fstroobandt/IR_line_follower/YouTube_links.txt

Youtube Links:

Auto met 2 wielen:
https://www.youtube.com/watch?v=cxPOhy2jSIM

Auto met 4 wielen:
https://www.youtube.com/watch?v=XgcI8E7g9I4
