fstroobandt/IR_line_follower/Documentatie IoT Project week 7.docx

# Documentatie IoT Project

Frederik Stroobandt

1Gr – IoT Thomas More Hogeschool

Sint-Katelijne-Waver, Campus De Nayer

30 mei ’21 (Week 7)

# 1 Code

## Screenshots van code

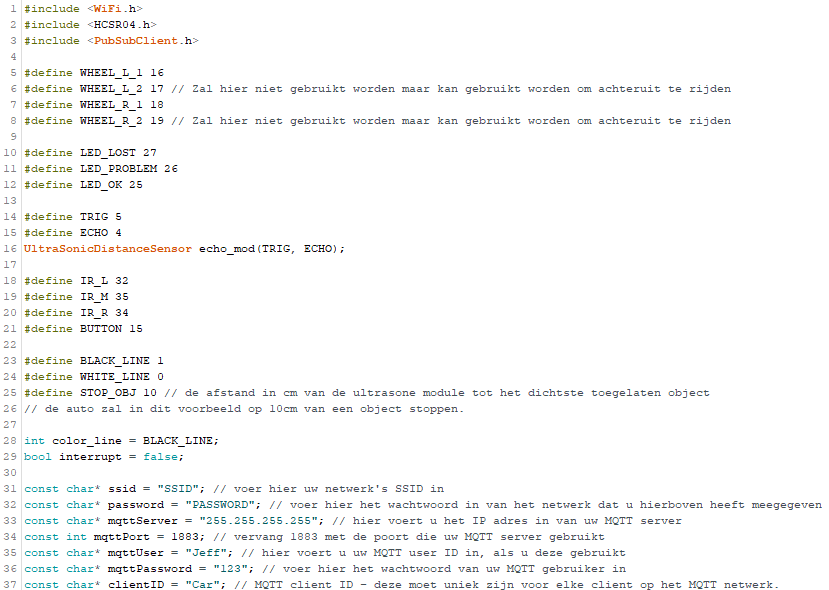
[picture p1: figure]
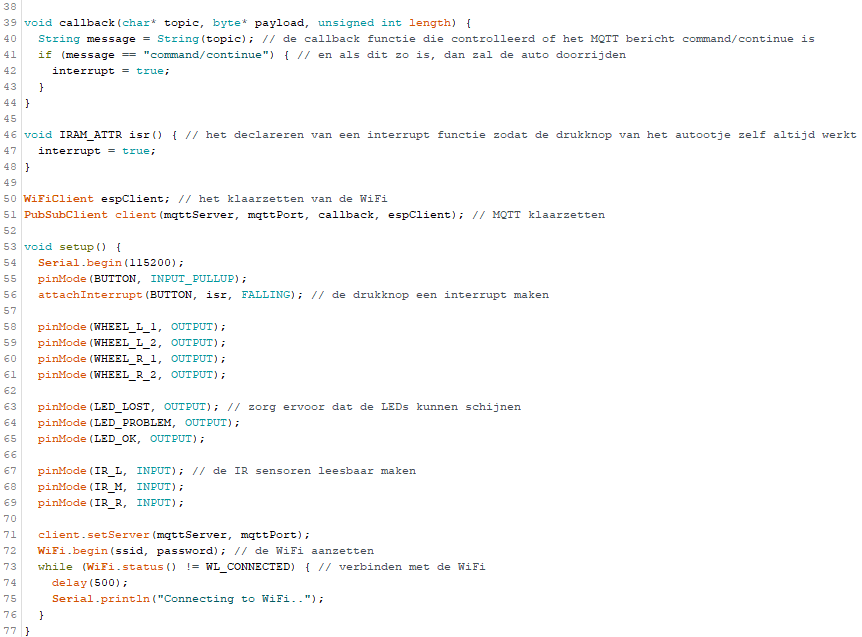
[picture p2: figure]
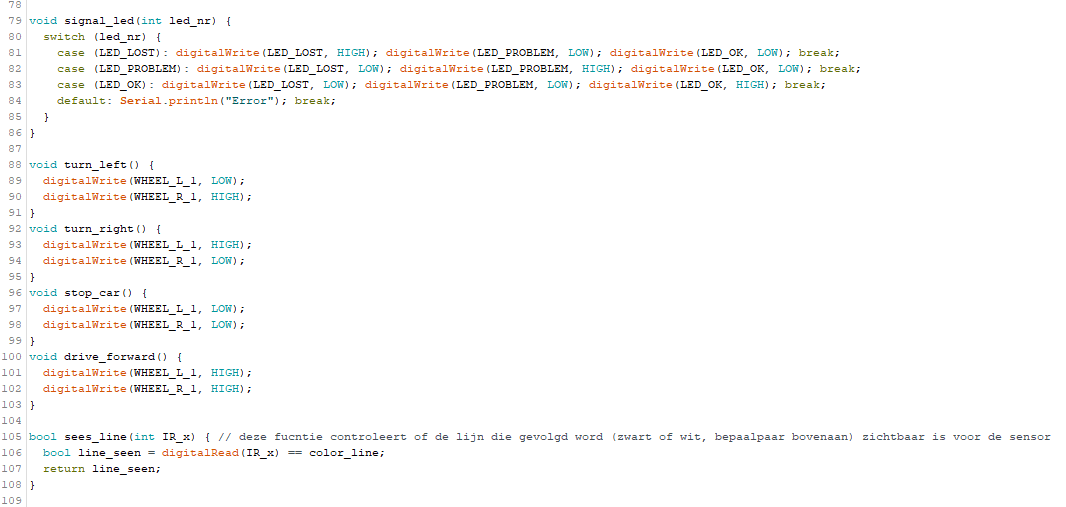
[picture p3: figure]
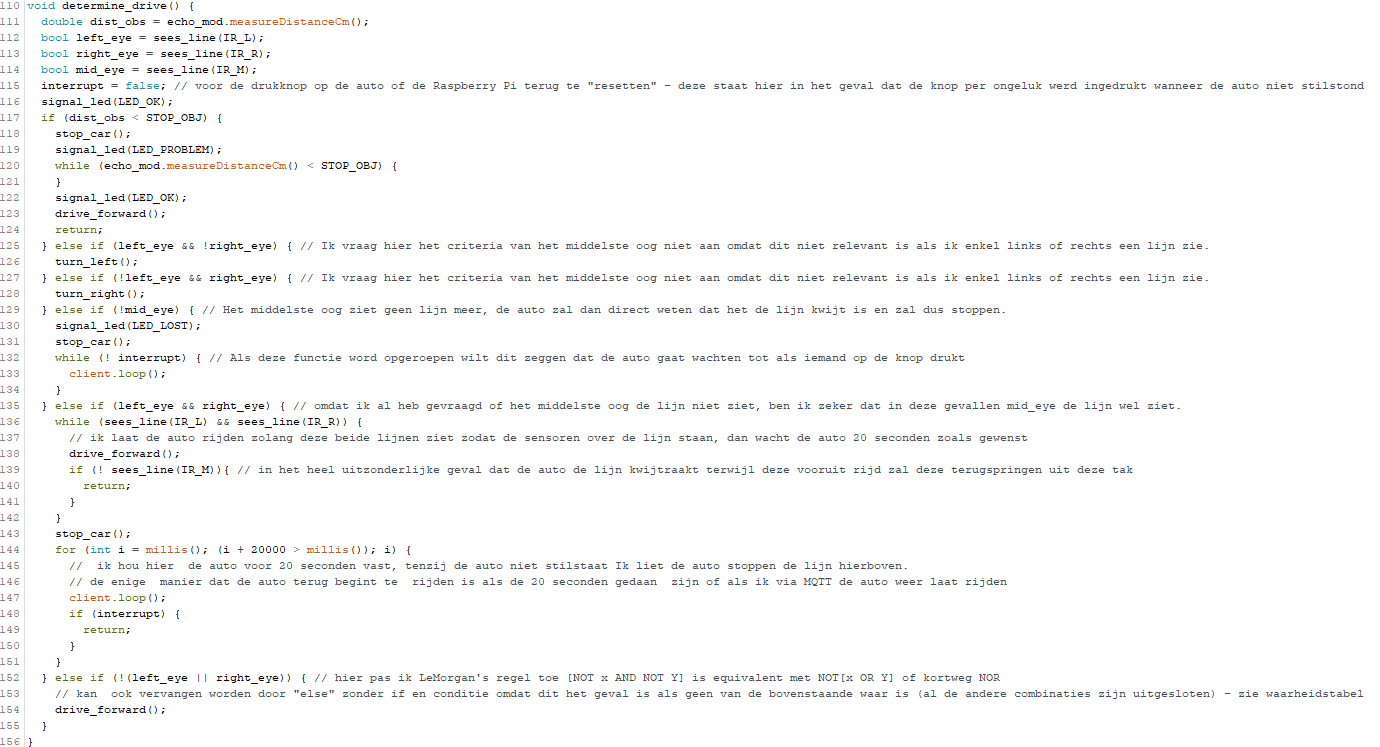
[picture p4: figure]
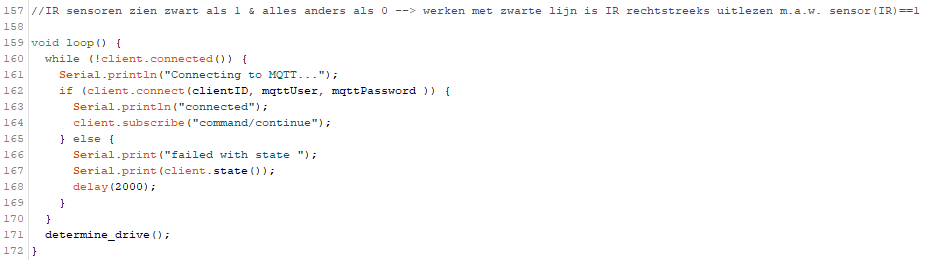
[picture p5: figure]

## Uitleg

In de eerste drie lijnen code roep ik libraries aan die ik nodig zal hebben voor deze robot te maken, de voornaamste twee zijn de WiFi.h en de PubSubClient.h libraries die ervoor zullen zorgen dat ik dankzij MQTT-berichten zal kunnen ontvangen. De HCSR04.h library is de library die mij de Ultrasone sensor laat uitmeten in centimeters zodat ik zelf geen berekening meer moet doen a.d.h.v. de snelheid van geluid.

In de lijnen 4 t.e.m. 37 declareer ik variabelen, objecten en constanten die ik later in mijn code gebruik zodat ik slechts op een plaats in mijn code een aanpassing moet maken als ik bedrading aanpas.

In dit stuk kan u aanpassen welke kleur lijn u volgt (lijn 28 int color_line=…), en u moet tussen lijnen 31 en 37 de code aanpassen zodat deze werkt met uw netwerk en uw MQTT-netwerk.

Tussen lijnen 38 en 52 declareer ik nog twee functies die Setup() nodig heeft. De callback functie voor MQTT berichten te verwerken en isr(), een functie die als interrupt werkt voor de ESP32, hierna worden de espClient en client objecten aangemaakt voor te verbinden met WiFi en MQTT.

Tussen 53 en 77 gebeurt de setup, hier declareer ik welke pinnen er als output zullen dienen en welke als input, ik vertel mijn WiFi en client objecten eveneens welke SSID en MQTT-server ze respectievelijk mee moeten verbinden. En dan wacht ik tot er een verbinding is gemaakt tussen de ESP32 en de WiFi. Dit wil zeggen: zonder WiFi zal de auto niet werken.

De functie signal_led krijgt meegegeven welke LED aan moet springen, en zal de twee andere uitschakelijken, dit doe ik aan de hand van een switch case, dit heb ik gedaan in een functie in het geval ik meerdere keren van LED moet veranderen en heb zo van 3x (# keer van LED veranderen) naar 7 + (#keer van LED veranderen) lijnen code gegaan.

In de turn_left, turn_right, stop_car en drive_forward functies gebruik ik heel simpele code zodat het leesbaarder is.

sees_line(int IR_x) is weeral een functie die niet per se nodig is, maar wel handig is voor de leesbaarheid van de hele code.

determine_drive() is het brein van de code van de auto, hierin wordt bepaald hoe de auto moet rijden, in de eerste vier lijnen maakt de functie 4 lokale variabelen aan en houd deze bij zodat elke vergelijking in de body met gelijke parameters verloopt. Eerst kijkt de functie of er geen object te kortbij staat, in dit geval slechts 10 centimeter, ik vertel de auto om dan onmiddellijk te stoppen en de oranje/gele LED aan te zetten zodat er visueel gesignaleerd wordt dat de auto is gestopt wegens een obstakel. Zodra het obstakel meer dan 10 cm verwijderd is zal de Auto de groene LED aanzetten en gewoon vooruitrijden (dit kan ik nog verwijderen).

In de tweede IF-tak wordt gecontroleerd of het linkeroog de streep ziet, maar het rechteroog niet, zo ja, dan slaat de auto links af. In de derde IF-tak gebeurt het omgekeerde, of het rechteroog de streep ziet maar het linkeroog niet, zo ja, dan slaat de auto rechts af.

Op lijn 129 wordt er voor de eerste (en enige) keer naar de meting van het middelste oog gekeken. Als deze geen lijn ziet dan slaat de auto stil, de rode lamp zal aanduiden dat de auto is gestopt en niet verder zal rijden tot er op een knop wordt gedrukt, en zal pas in een andere tak springen als het probleem is opgelost.

Hierna kijkt de wagen of beide sensoren de lijn zien, zo ja, dan blijft het rijden tot het over de streep staat en dan stopt het. Zodra deze of 20 seconden heeft gewacht aan de lijn, of een signaal krijgt van het commandocentrum zodat de wielen weer draaien, zal de loop voortgaan en wacht de auto niet meer.

De laatste tak is enkel vooruitrijden, als de twee buitenste ogen niets uitlezen, (en het middelste oog wel – dit is impliciet gecontroleerd door lijn 129), dan zal de auto vooruitrijden.

In de loop zal er telkens een connectie gemaakt worden met de MQTT-server, zodat de auto de MQTT-berichten van het commandocentrum kan ontvangen en deze kan verwerken a.d.h.v. de geschreven callback functie, deze zal de nuttige berichten van de nutteloze berichten scheiden. En dan op het einde van de loop roep ik determine_drive() aan zodat de robotauto de lijn kan volgen. Dit wil zeggen: De Auto zal niet werken zonder MQTT.

### Code zonder WiFi en MQTT

Als u de code wilt zonder dat WiFi en MQTT gebruikt worden moet u een beetje code weghalen.
Te verwijderen lijnen (Ik raad aan om onderaan te beginnen, dan blijven de lijnnummers juist):
1, 3, 30 t.e.m. 44, 50 t.e.m. 52, 70 t.e.m. 76, 133, 147 en dan 160 t.e.m. 170.

Er zal ook een download link zijn op GitHub voor de code zonder WiFi en MQTT.

## Waarheidstabel voor de 3 IR-ogen

↓ Scenario | left_eye | mid_eye | right_eye
Lost | 0 | 0 | 0
Right | 0 | 0 | 1
Drive | 0 | 1 | 0
Right | 0 | 1 | 1
Left | 1 | 0 | 0
Lost | 1 | 0 | 1
Left | 1 | 1 | 0
Stop | 1 | 1 | 1

In deze waarheidstabel kunnen we zien dat er slechts 5 scenario’s zijn die we nodig hebben. Dus om van 8 scenario’s (alle mogelijke combinaties) naar 5 te gaan en meerdere gevallen tegelijk te tackelen zullen we kijken naar de variabelen die het meeste doen om een scenario te bepalen.

Voor Left zien we dat left_eye gelijk moet zijn aan 1 en right_eye moet gelijk zijn aan 0, dit wil zeggen dat mid_eye er niet toe doet, hetzelfde geldt voor Right, maar de waardes van right_eye en left_eye zijn 1 en 0 respectievelijk voor dit scenario. Dit wil zeggen dat we met deze twee geen variabelen kunnen uitsluiten en er zijn nog 4 andere “scenario’s” mogelijk.

Met Lost zien we dat mid_eye uitsluitend 0 mag zijn, maar de andere twee doen er niet meer toe. Dit neemt 2 van de 4 overblijvende basis-scenario’s weg. En als we kijken zien we dat deze twee beide mid_eye gelijk aan 1 over houden, en sterker nog left_eye en right_eye zijn gelijk aan elkaar.

Dit wil zeggen dat ik zelfs door enkel een van de twee te testen kan zien in welke tak ik zal belanden. Maar ik had besloten om deze twee nog altijd expliciet te testen en geen “else” tak te gebruiken.

Moest ik het nog compacter willen schrijven dan kon ik het volgende doen.

If (left_eye && !right_eye){ // dit is de left-tak
…} else if (right_eye && !left_eye){ // dit is de right-tak
…} else if (!mid_eye){ // dit is de lost-tak
…} else if (right_eye){ // test of ik in stop of drive zit – dit is de stop tak
…} else {…} // dit is de drive-tak

# 2 Hardware & aankopen

## Kosten

Ik laat hier enkele prijzen buiten beschouwing, namelijk de prijzen van de soldeerbout, het soldeersel, de bouten en moeren of vijzen die u gebruikt, de female-to-male en male-to-male kabels, de 3 LEDs en de drukknop, deze maakte deel uit van een kit waarvan ik de prijs niet ken.

U zult hier zien dat ik in een kit 0.5 als een hoeveelheid nodig heb gelijst, dit is omdat de kit die ik gebruikt heb gemaakt is om één auto met 4 wielen en motoren te maken, hierdoor moet men het zwenkwiel apart kopen. Maar hierdoor krijgt u wel voldoende chassis, motoren en wielen om 2 wagens te maken. Dit komt goedkoper uit dan de 2 wielen kit te kopen per auto.

Hier gebruik ik een powerbank in plaats van een veel goedkopere 9V batterij en batterij aansluiting omdat de ESP32 die hier gebruikt wordt te veel stroom vraagt, dit kan niet geleverd worden als de batterij ook de wielen moet aandrijven. De powerbank levert 2.1A maximaal wat meer als voldoende is.

Doordat ik gebruik maak van Amazon hier en al de gekozen producten genieten van Amazon’s levering kost verlaging moet u geen kosten rekenen voor verzendingen.

Benodigdheden

Hardware:

- 1 chassis die 15 bij 20 meet (https://www.amazon.de/gp/product/B07JK33HVL/)
- 1 blanco 5x7cm PCB (https://www.amazon.de/gp/product/B0728HZHTR/) of 2 Breadboards die minstens 20 x 5 gaten zijn elk (om de ESP32 op te pinnen)
- 1 klein breadboard (https://www.amazon.de/gp/product/B07GKVTM88/)
- 1 L298N motor drive controller (https://www.amazon.de/-/en/product/dp/B07MY33PC9/)
- 38-pin ESP32 (https://www.amazon.de/gp/product/B074RG86SR/)
- 1 drukknop
- 3 LEDs – 1 groen, 1 geel, 1 rood
- 3 IR sensoren type (https://www.amazon.de/gp/product/B07VP4HBY6/) TCRT5000
- 1 HC-SR04 Ultrasone sensor (https://www.amazon.de/gp/product/B07SJSPXLT/)
- 2 wielen (https://www.amazon.de/gp/product/B07JK33HVL/) en een zwenkwiel (https://www.amazon.de/-/en/product/dp/B08NYWCJDX) (of knikker en een knikker houder)
- 2 dc-motoren (https://www.amazon.de/gp/product/B07JK33HVL/)
- 1 powerbank (https://www.amazon.de/-/en/product/dp/B07Z6N28RD) – zo compact mogelijk met 5V/2.1A output
- 1 USB-to-micro-USB kabel
- Een bundel male-to-male kabels
- Een bundel male-to-female kabels

Tools:

- Schroevendraaier
- Mes
- Bouten & moeren
- Dubbelzijdige plakband
- Soldeerbout
- Soldeersel
- Een wel geventileerde ruimte

## Assemblage

Disclaimer: ik heb geen handleiding voor het ineensteken van het autootje met de custom PCB. Ik heb namelijk zelf de custom PCB niet laten maken en kan dus niet demonsteren hoe dit moet.

### Stap 0)

Zorg dat je al de benodigdheden klaar hebt zodat u in een keer alles kan maken.

### Stap 1)

Neem uw dc-motoren, u zult zien dat er twee kleine koperen loops zijn, aan deze soldeert u een rode en een zwarte draad, zodat u een plus en een min kan bepalen. Dit is belangrijk voor de aansluitingen later dat u dit juist doet.

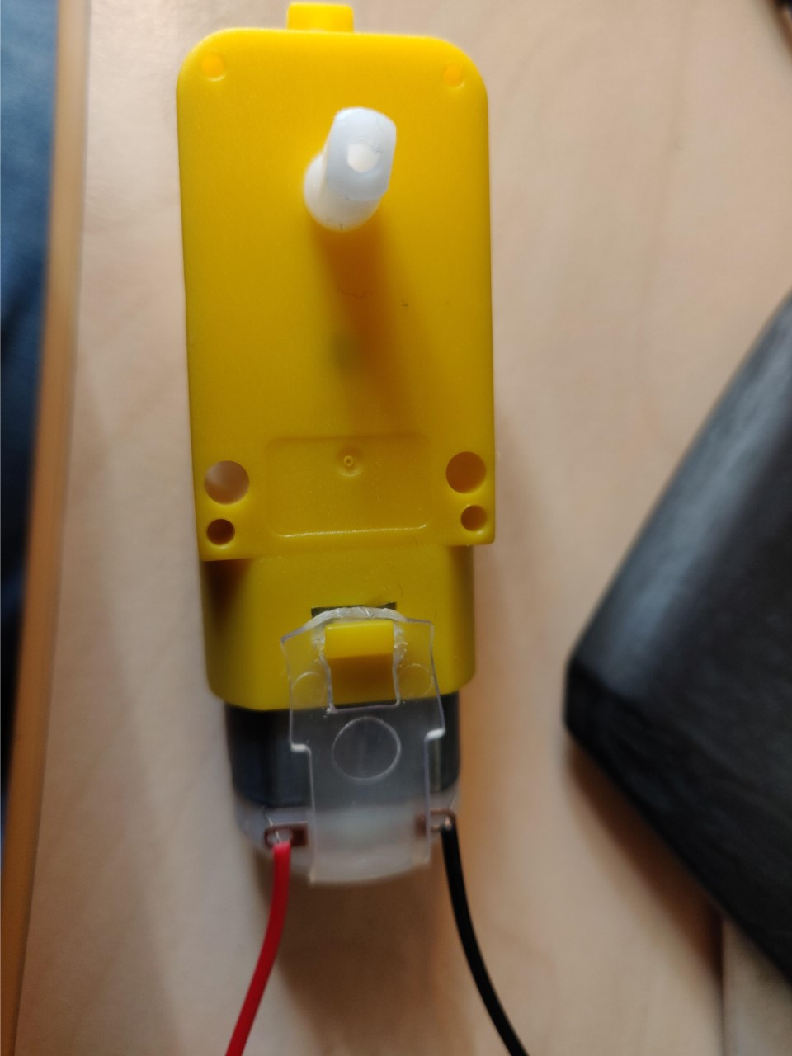
[picture p6: figure]

### Stap 2)

Monteer uw motoren op uw chassis op uw methode, ik heb ze onderaan mijn plastiek chassis gemonteerd zodat de auto niet gekanteld stond door het zwenkwiel, u mag nu ook al het zwenkwieltje monteren.

### Stap 3)

Verbind de vers gesoldeerde dc-motoren met de L298N op volgende wijze:

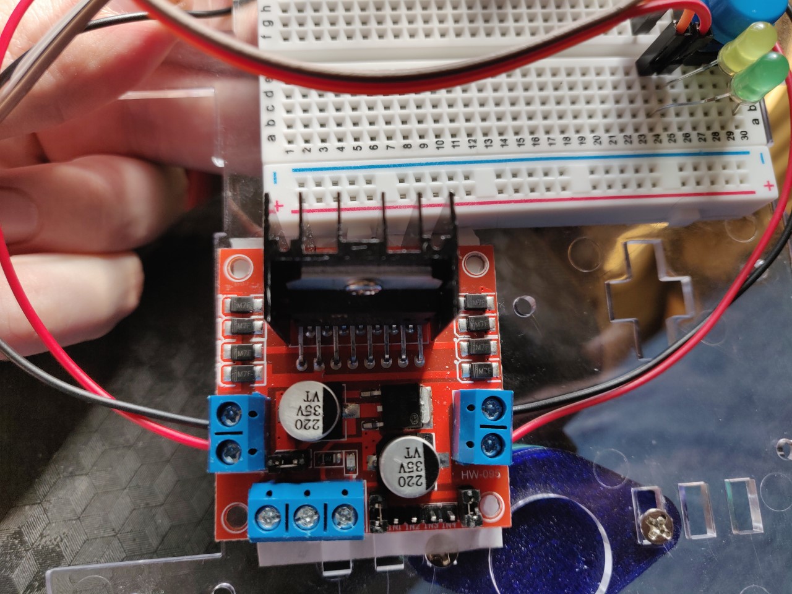
[picture p7: figure]

### Stap 4)

Neem de blanco 5x7cm PCB en neem enkele van de volgende pinnen. Zie dat u 4 strookjes heeft van 19 pinnen lang elk, en dan nog een strookje van 18 lang en dan nog eens twee van 5 tot 7 lang.

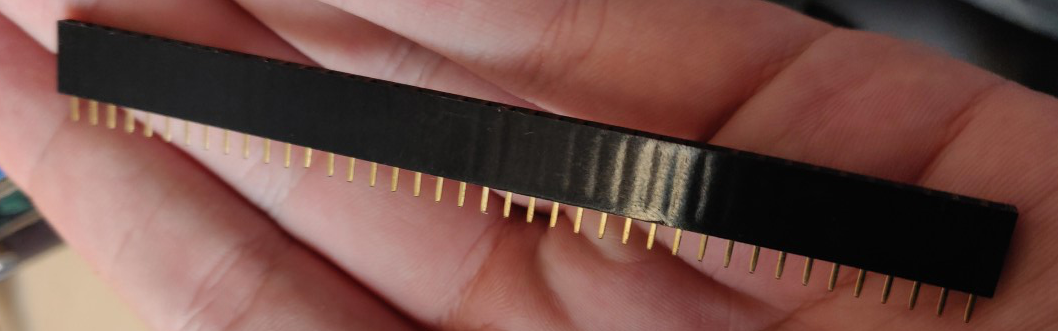
[picture p8: figure]

Soldeer deze vast zodat u dit patroon krijgt:

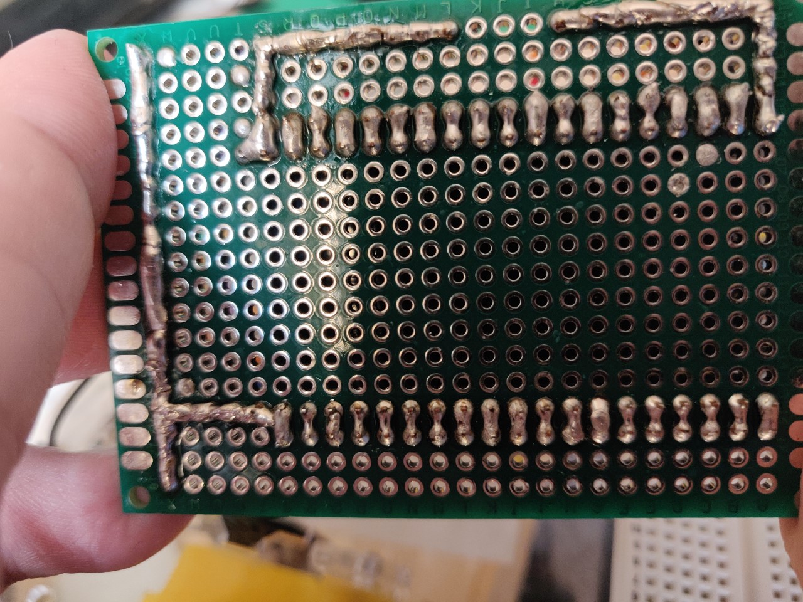
[picture p9: figure]

### Stap 5)

Monteer uw IR sensoren en HC-SR04 vooraan op uw wagen en plaats uw PCB hier achter (zet deze vast met dubbelzijdige plakband als u geen passende bouten heeft), met genoeg ruimte tussen de sensoren en het PCB voor kabeltjes te buigen waar nodig.

Om deze sensoren vast te steken heeft u bouten en moeren, zipties of vijzen nodig.

### Stap 6)

Achter uw PCB kan u uw breadboardje plakken voor uw knop en LEDs op te monteren. U kunt hier ook ineens uw powerbank plaatsen voor gewichtsdistributie zolang dat dit genoeg plaats laat voor uw L298N te plaatsen.

### Stap 7)

Plug uw 38-pin ESP32 in uw PCB georiënteerd als volgende:

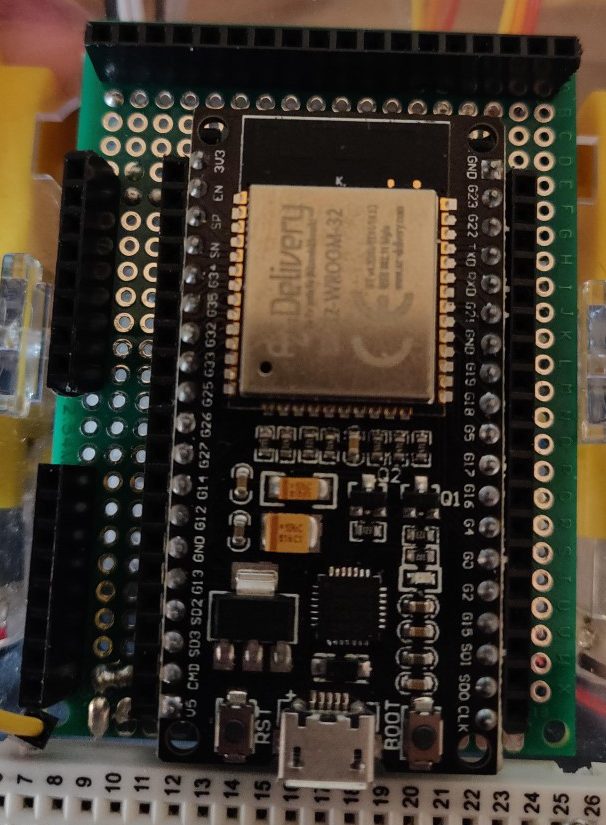
[picture p10: figure]

Ga naar Deel 3 – Schema’s en sluit de bekabeling aan zoals aangegeven op dat schema.

### Stap 8)

Open uw webbrowser en installeer Arduino.exe als u dit nog niet geïnstalleerd heeft, en installeer de ESP32 libraries.

Navigeer naar https://github.com/fstroobandt/IR_line_follower hier downloadt u “Week_7_IoT.ino” als u een wilt met WiFi en MQTT, zo niet dan downloadt u de andere .ini file

### Stap 9) – enkel voor WiFi & MQTT

Open Week_7_IoT.ino en pas hier de code aan om te passen bij uw WiFi netwerk en uw MQTT-netwerk, hier past u ook aan welke kleur lijn u gaat volgen, u kan kiezen tussen zwart en wit.

### Stap 10) – enkel voor WiFi & MQTT

Zet uw MQTT-server aan en zorg dat het controlecentrum dat u gebruikt, en dat de knop die u wilt gebruiken het volgende bericht zenden om de auto voort te laten rijden “command/continue”.

### Stap 11)

Verbind uw ESP32 met uw computer via een microUSB naar USB kabel die data kan schrijven. Dan selecteerd u in het .ino bestand onder tools “NodeMCU-32S” als microcontroller. Dan uploadt u de code.

### Stap 12)

Eenmaal de code is geüpload kan u de ESP32 loskoppelen van de computer. U moet nog één kabeltje trekken normaalgezien. Daarna is het uw powerbank verbinden met uw ESP32 en deze zal de kleur lijn volgen die u heeft gekozen*. De zwarte kabel leid naar GND van de ESP32 en de witte/grijze naar de 5V lijn. – deze voeden de L298N (en de motoren).

* Het kan zijn dat u nog uw IR-sensoren moet afstellen voor de donkerheid/lichtheid van uw vloer.

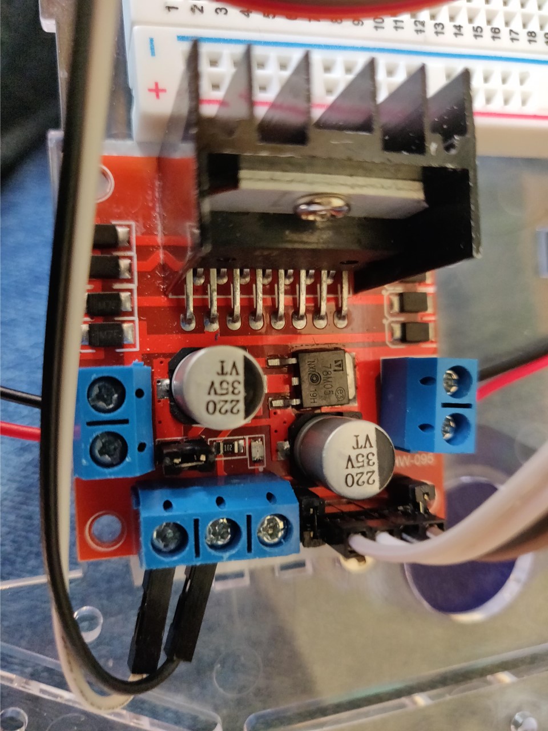
[picture p11: figure]

Dit zou gelijkaardig moeten zijn aan uw eindresultaat.

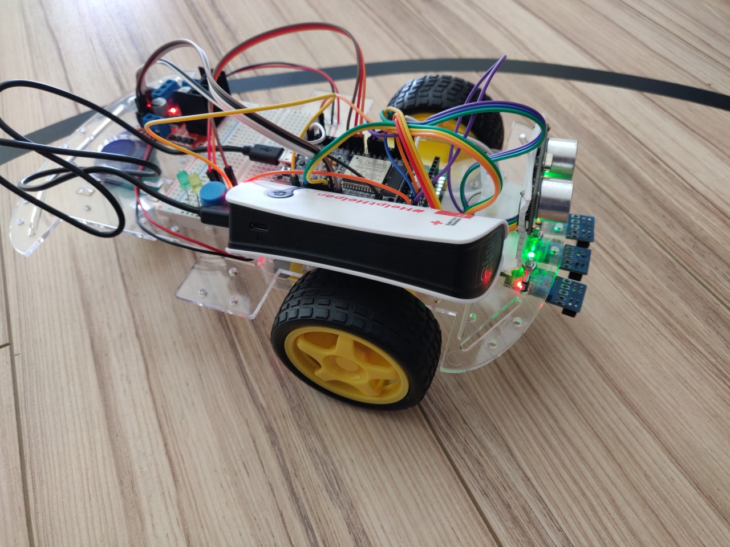
[picture p12: figure]

# 3 Schema’s

## Electronisch schema

Dit elektronisch schema laat enkel zien wat er op de PCB wordt aangesloten.

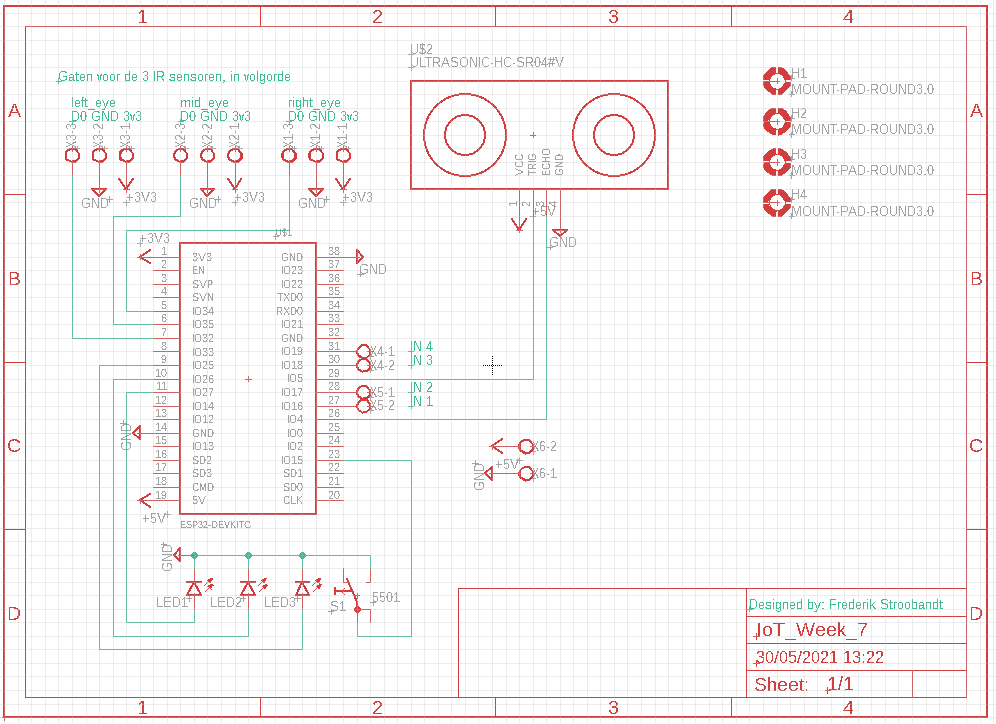
[picture p13: figure]

Ik kan hierop de dc-motoren niet laten zien gezien deze op de L298N worden aangesloten en deze wordt dan op keer aangesloten op dit schema via Screwterminals (zie IN 4, IN 3, IN 2 en IN 1) De IR-sensor aansluitingen zijn hier vervangen door drie 3-poortige screwterminals. Dit heb ik gedaan zodat u male-to-female jumpers kan gebruiken om aan te sluiten en omdat er geen goede library te vinden was voor de IR sensoren die ik gebruik.

## PCB

De PCB meet 67.31 mm bij 86.34 mm, een zeer compacte PCB.

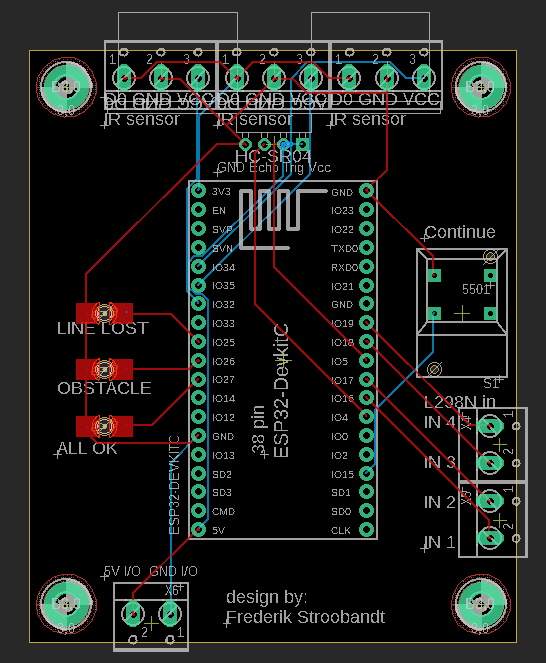
[picture p14: figure]

Het PCB is mogelijks niet volledig leesbaar. Dit komt omdat ik zowel op de onderkant als bovenkant tekst laat printen.

U ziet ook dat de ESP32 nog veel pinnen over heeft, dit wil zeggen dat ik deze eigenlijk nog compacter zou kunnen maken als ik een kleinere microcontroller had gebruikt. Ik heb ook expres de I2C pinnen niet gebruikt zodat hier op nog uitbreiding kunnen komen zo gewenst.

Natuurlijk ziet u hierop geen aansluitingen voor de IR-ogen op het eerste gezicht, dit is omdat hiervoor geen libraries bestonden, want de ogen zijn al PCBs, net zoals de L298N motorcontroller die wij gebruiken. De plaatsen om deze aan te sluiten staan vermeld op de PCB zelf. Voor de L298N heb je de screwterminals rechtsonder en de screwterminal linksonder voor stroom. Voor de 3 IR-sensoren zijn er drie keer drie punten voorzien onder de HC-SR04 Ultrasone module. Ik adviseer hier de draden rechtstreeks op te solderen in plaats van de screwterminals te installeren, deze screwterminals zouden te hoog zijn als u de HC-SR04 rechtstreeks op de PCB wilt solderen.

# 4 Link naar de GitHub pagina

https://github.com/fstroobandt/IR_line_follower
