fstroobandt/IR_line_follower/IoT_Week_7.brd

## EAGLE design IoT_Week_7.brd (2021-05-30)

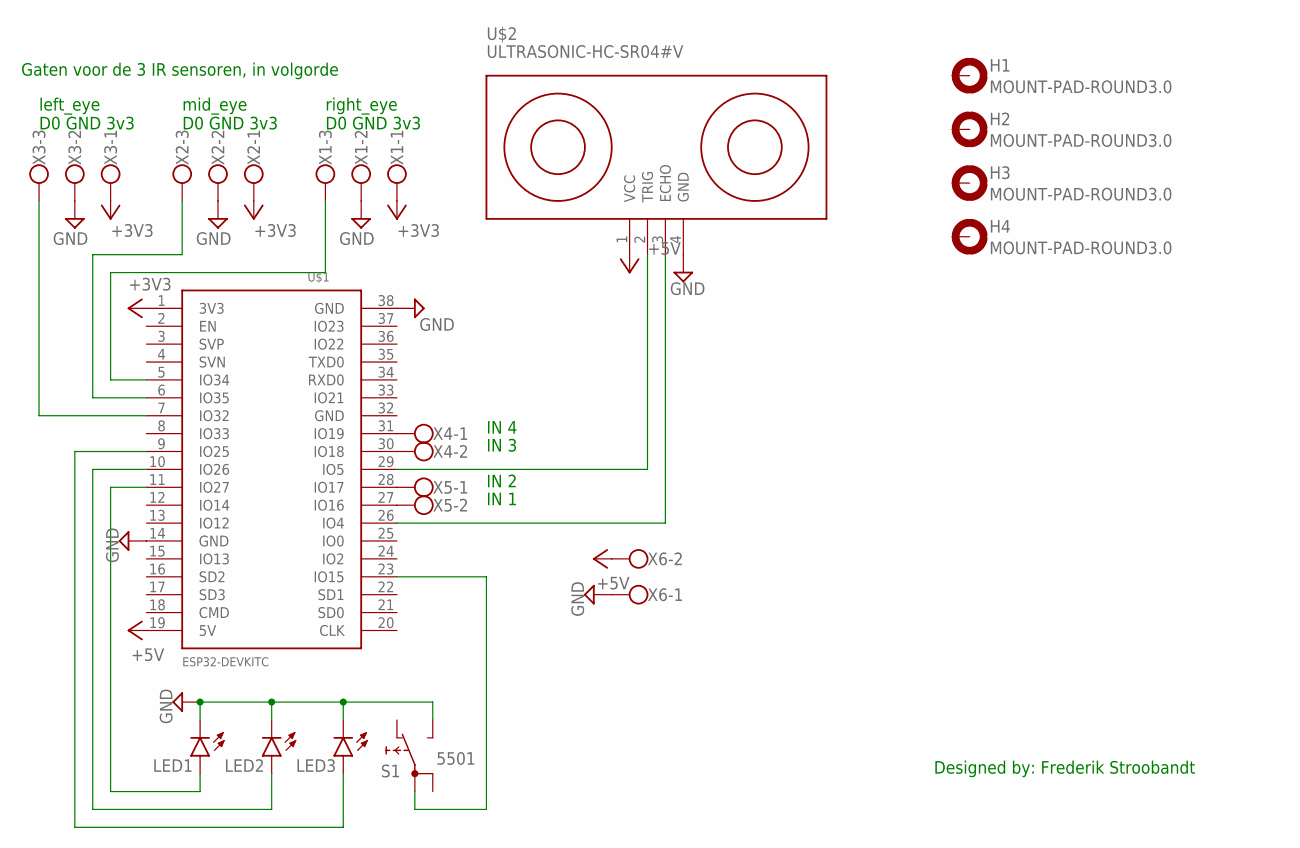
[picture p15: schematic IoT_Week_7.sch]

Parts:
H1, H2, H3, H4: MOUNT-PAD-ROUND3.0; 3,0-PAD
LED1, LED2, LED3: LAP4-BOTTOM; P47F-BOTTOM
S1: 5501
U$1: ESP32DEVKITC; ESP32-DEVKITC
U$2: ULTRASONIC-HC-SR04#V
X1, X2, X3: W237-103
X4, X5, X6: W237-102

Connections:
+3V3: U$1.1 (3V3), X1.1, X2.1, X3.1
+5V: U$1.19 (5V), U$2.1 (VCC), X6.2
GND: LED1.C, LED2.C, LED3.C, S1.NO, U$1.14 (GND), U$1.38 (GND), U$2.4 (GND), X1.2, X2.2, X3.2, X6.1
unnamed: U$1.27 (IO16), X5.2
unnamed: U$1.28 (IO17), X5.1
unnamed: U$1.31 (IO19), X4.1
unnamed: U$1.30 (IO18), X4.2
unnamed: U$1.5 (IO34), X1.3
unnamed: U$1.6 (IO35), X2.3
unnamed: U$1.7 (IO32), X3.3
unnamed: LED3.A, U$1.9 (IO25)
unnamed: LED2.A, U$1.10 (IO26)
unnamed: LED1.A, U$1.11 (IO27)
unnamed: U$1.29 (IO5), U$2.2 (TRIG)
unnamed: S1.1A, U$1.23 (IO15)
unnamed: U$1.26 (IO4), U$2.3 (ECHO)

Notes on the sheet:
Gaten voor de 3 IR sensoren, in volgorde
left_eye D0 GND 3v3
mid_eye D0 GND 3v3
right_eye D0 GND 3v3
IN 4
IN 3
IN 2
IN 1
Designed by: Frederik Stroobandt

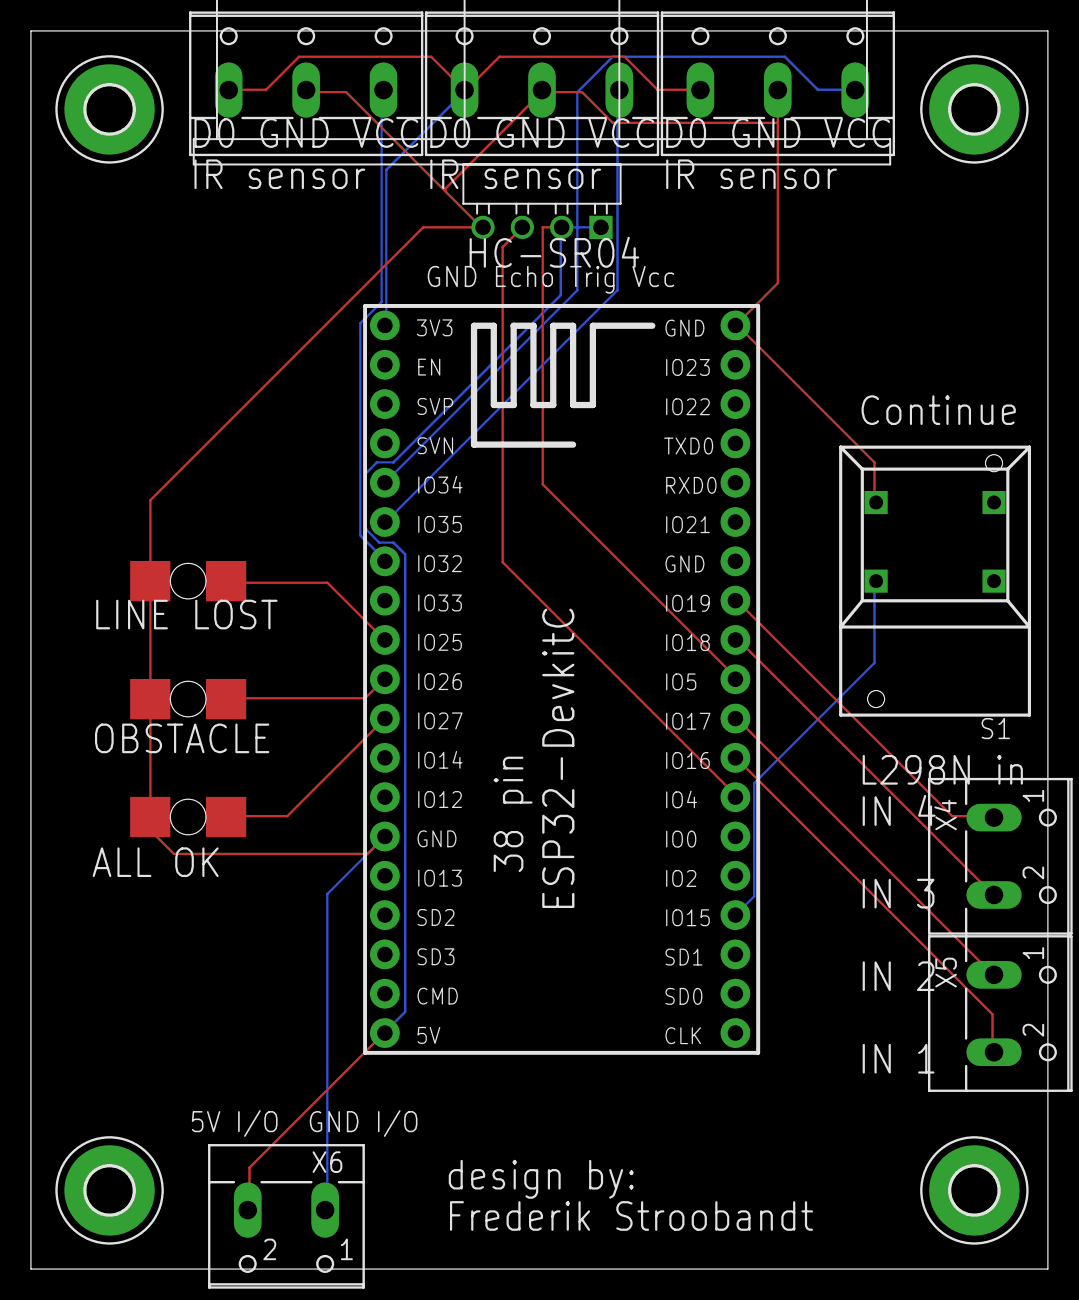
[picture p16: board IoT_Week_7.brd from above]

Board: 2 copper layers, 65.7 x 80.0 mm, 16 parts (0 on the bottom side), 16 nets.
